jconenna/Star-Adventurer-Dec-Ditherer/images/pcb.png

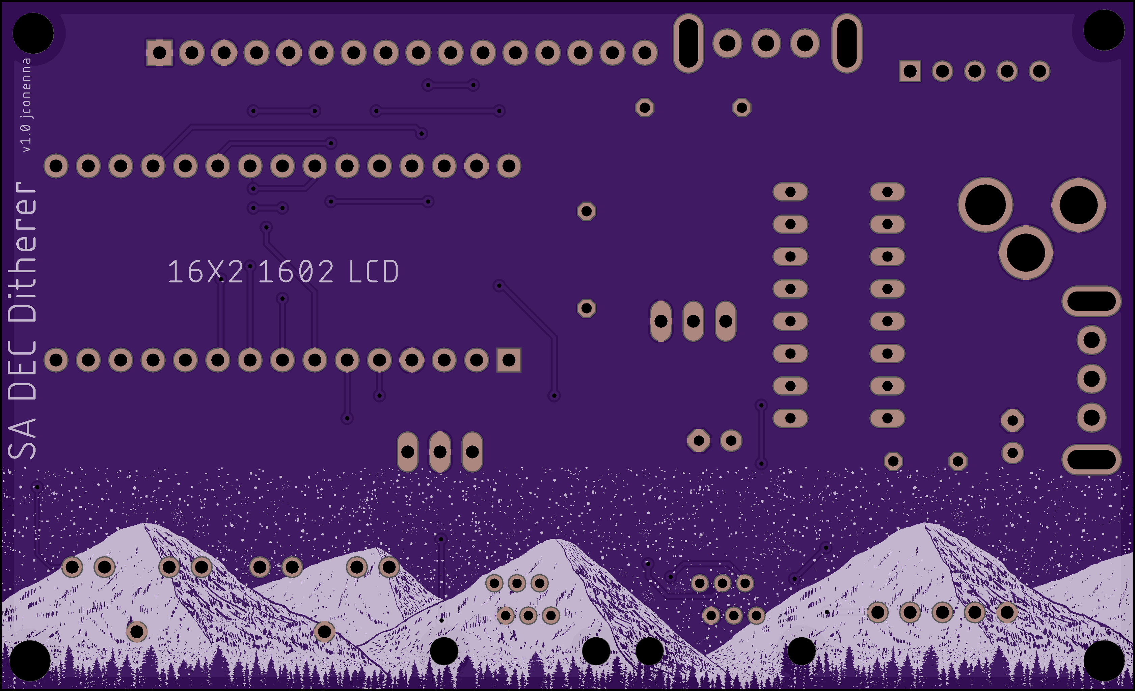
images/pcb.png
