jconenna/Star-Adventurer-Dec-Ditherer/sa_dec_bracket.stl

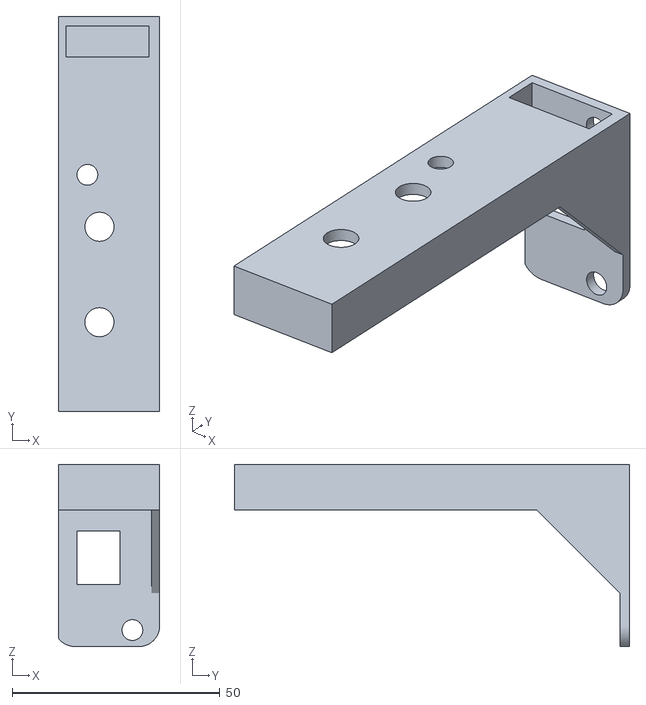
[picture p7: CAD file, 2022-01-31]
sa_dec_bracket.stl
24.4 x 95.1 x 43.9
