jconenna/Star-Adventurer-Dec-Ditherer/sa_box_top.stl

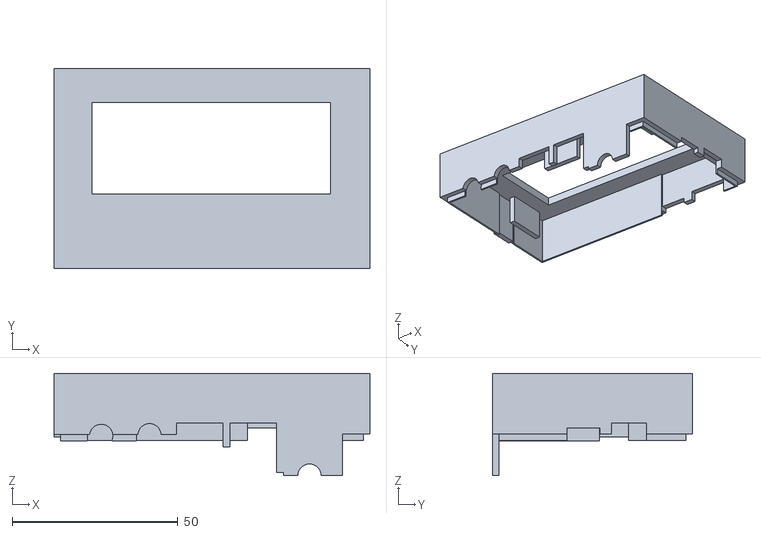
[picture p8: CAD file, 2022-01-31]
sa_box_top.stl
95.3 x 60.5 x 30.9
