jconenna/Star-Adventurer-Dec-Ditherer/sa_box_bottom.stl

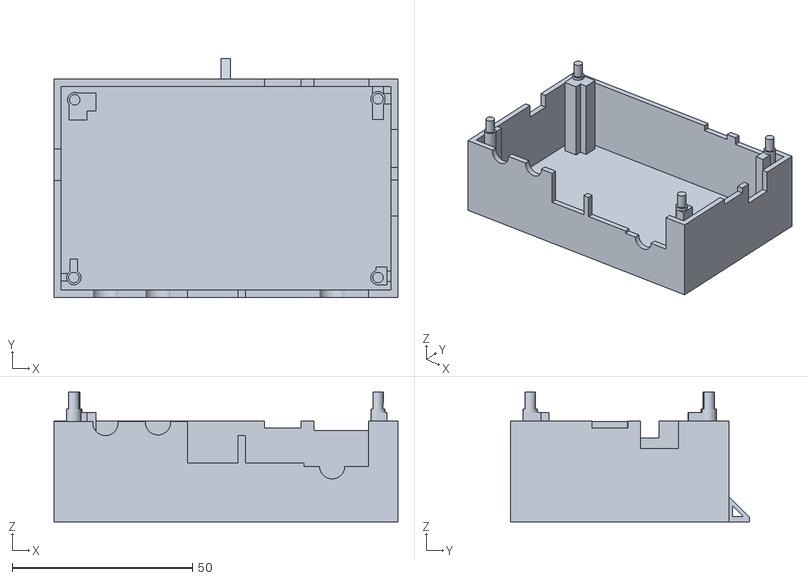
[picture p9: CAD file, 2022-01-31]
sa_box_bottom.stl
95.4 x 66.2 x 36.0
