jconenna/Star-Adventurer-Dec-Ditherer/schematic.pdf

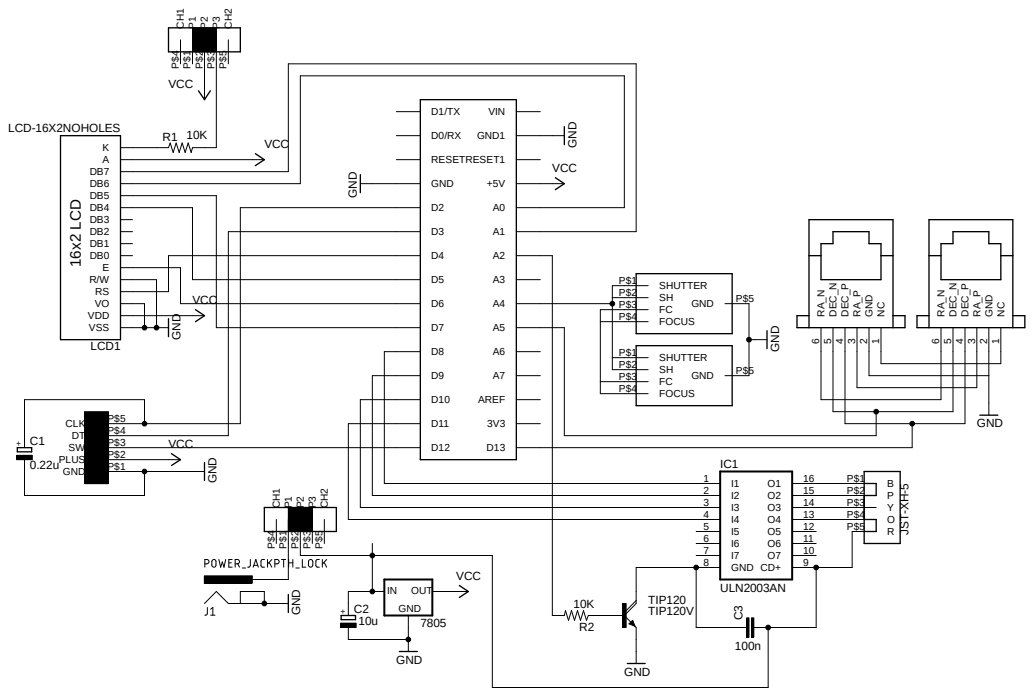
[picture p10: page 1]
