jconenna/Star-Adventurer-Dec-Ditherer/(commit log)

2022-09-10 Update dec_ditherer.ino
    Fixed UI bug
    [dec_ditherer.ino]
2022-09-10 Update dec_ditherer.ino
    updated print_dither_px() to fix UI bug
    [dec_ditherer.ino]
2022-10-09 Update dec_ditherer.ino
    Added show arcmin for SA App after setting dither amount. Removed all Serial debug prints.
